adriancubasalvarez/radio-mundial/carcasa/README.md

# Radio Mundial — 3D printed cases

**English** · [Español](#español)

| Folder | What it is | Status |
|---|---|---|
| [`pequena/`](pequena/) | **Small case** for the Freenove FNK0104, using the speaker that comes with the board. It is the one shown in the video and in the build guide. | Ready to print |
| [`boombox/`](boombox/) | Reference parts to design a larger boombox version with two 4" speakers. | In progress |

The small case is also on [MakerWorld](https://makerworld.com/en/models/3568249) and [Printables](https://www.printables.com/model/1905906).

---

## Español

| Carpeta | Qué es | Estado |
|---|---|---|
| [`pequena/`](pequena/) | **Carcasa pequeña** para la Freenove FNK0104, con el altavoz que trae la placa. Es la que sale en el vídeo y en la guía de montaje. | Lista para imprimir |
| [`boombox/`](boombox/) | Piezas de referencia para diseñar una versión boombox más grande, con dos altavoces de 4". | En desarrollo |

La carcasa pequeña también está en [MakerWorld](https://makerworld.com/es/models/3568249) y [Printables](https://www.printables.com/model/1905906).

Licencia / License: CC BY-NC-SA 4.0 — see [`LICENSE-CONTENIDO.md`](../LICENSE-CONTENIDO.md).
