adriancubasalvarez/radio-mundial/carcasa/boombox/referencia/amplificador_bloque.step

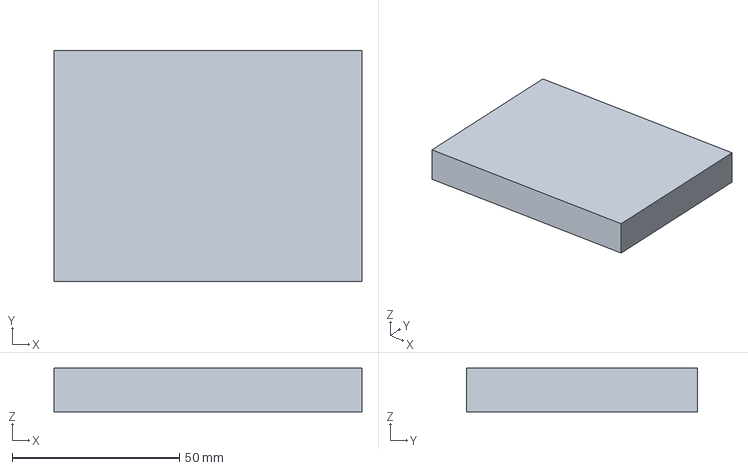
[picture p3: CAD file, 2026-11-08]
carcasa/boombox/referencia/amplificador_bloque.step
92.0 x 69.0 x 13.0 mm
