adriancubasalvarez/radio-mundial/carcasa/pequena/front.step

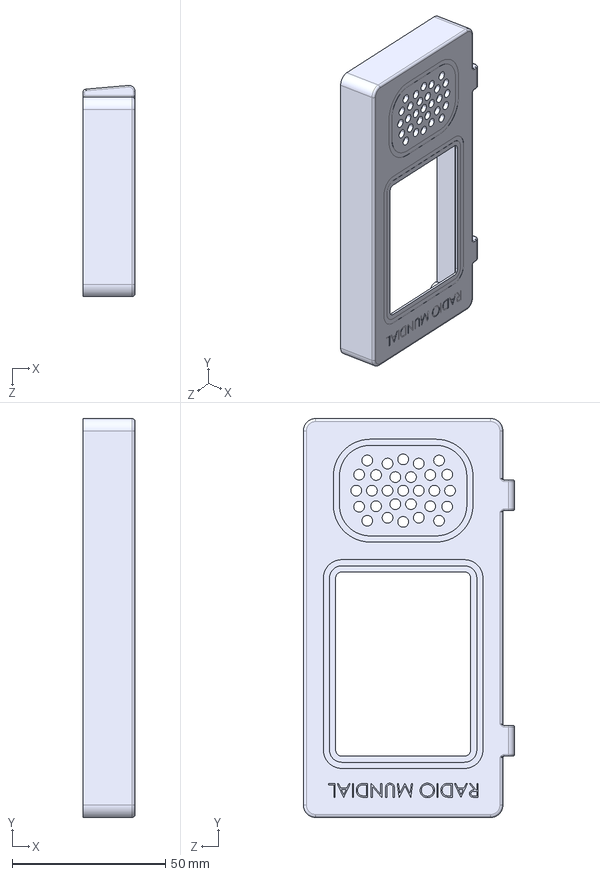
[picture p4: CAD file, 2026-11-07]
carcasa/pequena/front.step
17.0 x 130.0 x 68.8 mm
