adriancubasalvarez/radio-mundial/carcasa/boombox/referencia/altavoz_maniqui.step

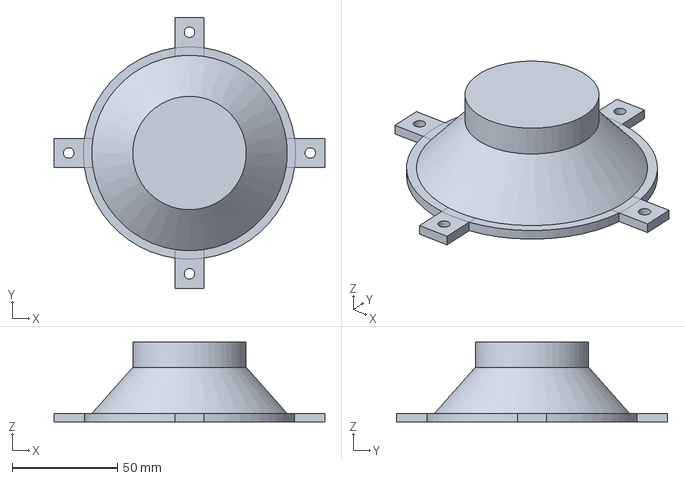
[picture p5: CAD file, 2026-11-08]
carcasa/boombox/referencia/altavoz_maniqui.step
129.0 x 129.0 x 38.0 mm
