adriancubasalvarez/radio-mundial/carcasa/pequena/back_cover.step

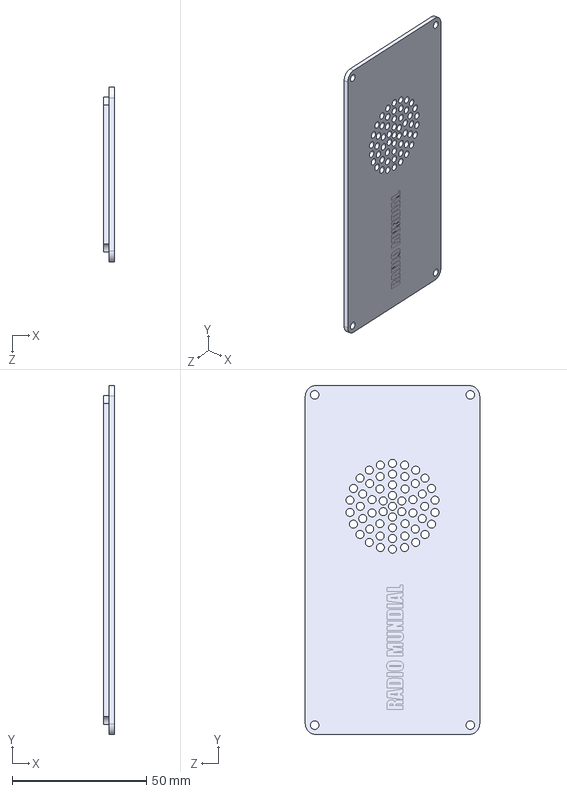
[picture p6: CAD file, 2026-11-07]
carcasa/pequena/back_cover.step
4.00 x 130.0 x 65.0 mm
