adriancubasalvarez/radio-mundial/carcasa/boombox/referencia/huevo_cavidad.step

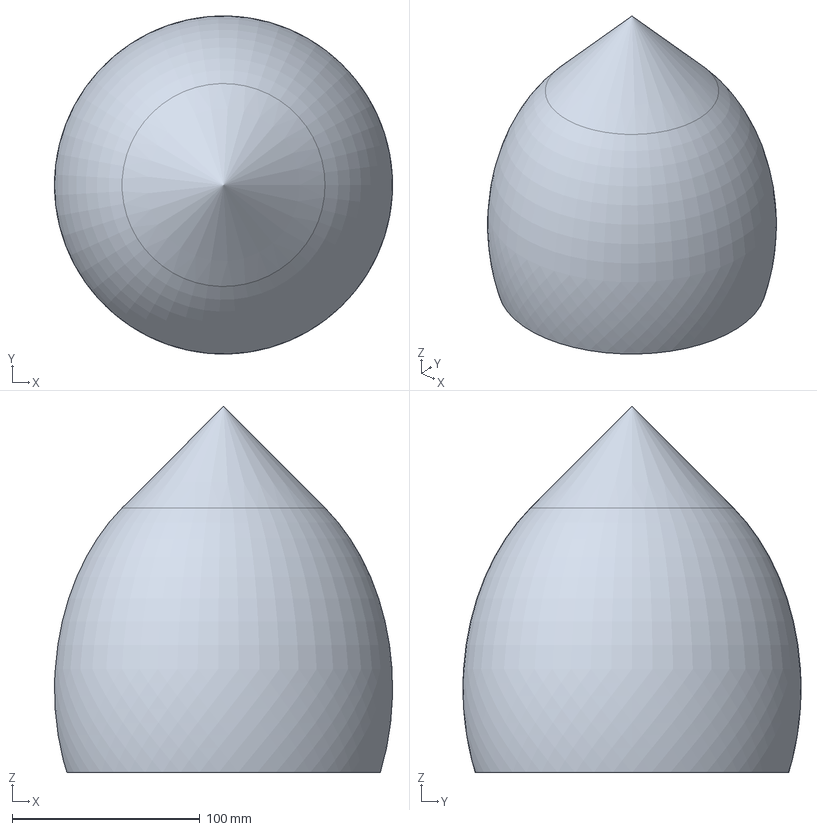
[picture p7: CAD file, 2026-11-08]
carcasa/boombox/referencia/huevo_cavidad.step
179.9 x 179.9 x 195.0 mm
