adriancubasalvarez/radio-mundial/(list of files, cad)

Other CAD files:
carcasa/boombox/referencia/altavoz_maniqui.stl
carcasa/boombox/referencia/amplificador_bloque.stl
carcasa/boombox/referencia/huevo_cavidad.stl
carcasa/pequena/back_cover.3mf
carcasa/pequena/back_cover.stl
carcasa/pequena/front.3mf
carcasa/pequena/front.stl
