adriancubasalvarez/radio-mundial/docs/manual/img/fotos/montaje.jpg

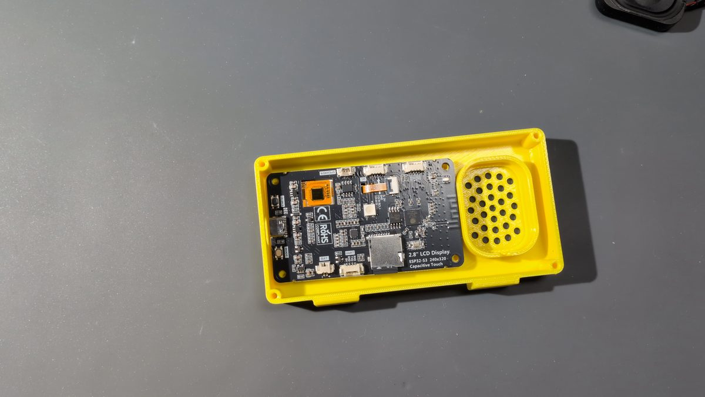
docs/manual/img/fotos/montaje.jpg
