adriancubasalvarez/radio-mundial/docs/manual/img/fotos/por_dentro.jpg

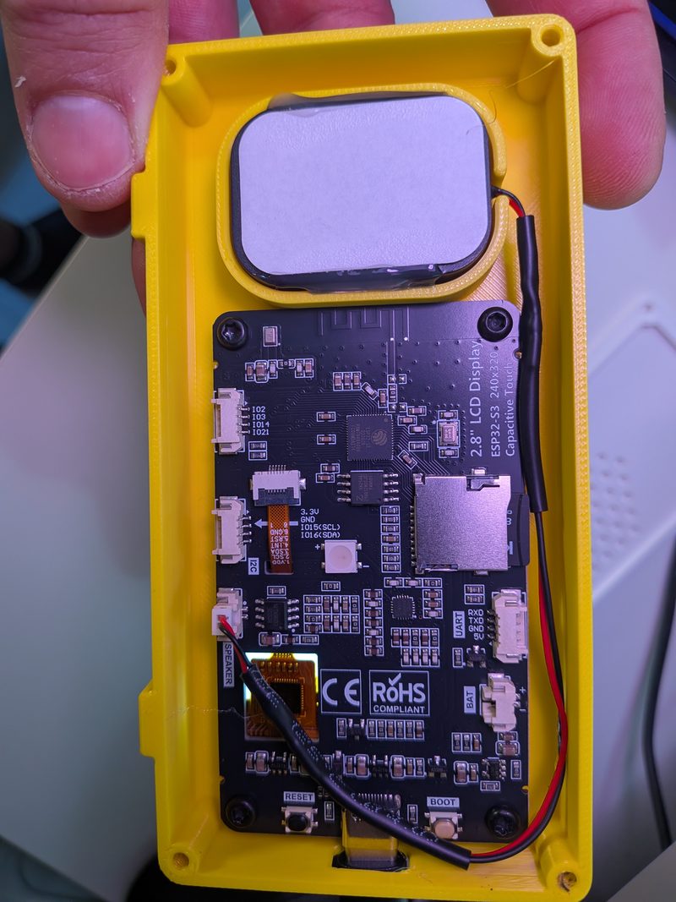
docs/manual/img/fotos/por_dentro.jpg
