adriancubasalvarez/radio-mundial/src/zonas.h

/* Generado por tools/build_zonas.py: no editar a mano.
 * Zona horaria de cada país (regla POSIX), ordenada por código. */
#pragma once

#include <stdint.h>

typedef struct {
    char codigo[3];
    const char *regla;
    uint32_t hasta;       /* si hay excepción, cuándo acaba (segundos Unix) */
    const char *despues;  /* y la regla que sigue */
} ZonaPais;

static const ZonaPais ZONAS[] = {
    {"AD", "CET-1CEST,M3.5.0,M10.5.0/3"},
    {"AE", "<+04>-4"},
    {"AF", "<+0430>-4:30"},
    {"AG", "AST4"},
    {"AI", "AST4"},
    {"AL", "CET-1CEST,M3.5.0,M10.5.0/3"},
    {"AM", "<+04>-4"},
    {"AO", "WAT-1"},
    {"AR", "<-03>3"},
    {"AS", "SST11"},
    {"AT", "CET-1CEST,M3.5.0,M10.5.0/3"},
    {"AU", "AEST-10AEDT,M10.1.0,M4.1.0/3"},
    {"AW", "AST4"},
    {"AX", "EET-2EEST,M3.5.0/3,M10.5.0/4"},
    {"AZ", "<+04>-4"},
    {"BA", "CET-1CEST,M3.5.0,M10.5.0/3"},
    {"BB", "AST4"},
    {"BD", "<+06>-6"},
    {"BE", "CET-1CEST,M3.5.0,M10.5.0/3"},
    {"BF", "GMT0"},
    {"BG", "EET-2EEST,M3.5.0/3,M10.5.0/4"},
    {"BH", "<+03>-3"},
    {"BI", "CAT-2"},
    {"BJ", "WAT-1"},
    {"BL", "AST4"},
    {"BM", "AST4ADT,M3.2.0,M11.1.0"},
    {"BN", "<+08>-8"},
    {"BO", "<-04>4"},
    {"BR", "<-03>3"},
    {"BS", "EST5EDT,M3.2.0,M11.1.0"},
    {"BT", "<+06>-6"},
    {"BW", "CAT-2"},
    {"BY", "<+03>-3"},
    {"BZ", "CST6"},
    {"CA", "EST5EDT,M3.2.0,M11.1.0"},
    {"CD", "WAT-1"},
    {"CF", "WAT-1"},
    {"CG", "WAT-1"},
    {"CH", "CET-1CEST,M3.5.0,M10.5.0/3"},
    {"CI", "GMT0"},
    {"CK", "<-10>10"},
    {"CL", "<-04>4<-03>,M9.1.6/24,M4.1.6/24"},
    {"CM", "WAT-1"},
    {"CN", "CST-8"},
    {"CO", "<-05>5"},
    {"CR", "CST6"},
    {"CU", "CDT4", 1825563600, "CST5CDT,M3.2.0/0,M11.1.0/1"},
    {"CV", "<-01>1"},
    {"CW", "AST4"},
    {"CY", "EET-2EEST,M3.5.0/3,M10.5.0/4"},
    {"CZ", "CET-1CEST,M3.5.0,M10.5.0/3"},
    {"DE", "CET-1CEST,M3.5.0,M10.5.0/3"},
    {"DJ", "EAT-3"},
    {"DK", "CET-1CEST,M3.5.0,M10.5.0/3"},
    {"DM", "AST4"},
    {"DO", "AST4"},
    {"DZ", "CET-1"},
    {"EC", "<-05>5"},
    {"EE", "EET-2EEST,M3.5.0/3,M10.5.0/4"},
    {"EG", "EET-2EEST,M4.5.5/0,M10.5.4/24"},
    {"EH", "<+00>0"},
    {"ER", "EAT-3"},
    {"ES", "CET-1CEST,M3.5.0,M10.5.0/3"},
    {"ET", "EAT-3"},
    {"FI", "EET-2EEST,M3.5.0/3,M10.5.0/4"},
    {"FJ", "<+12>-12"},
    {"FK", "<-03>3"},
    {"FM", "<+10>-10"},
    {"FO", "WET0WEST,M3.5.0/1,M10.5.0"},
    {"FR", "CET-1CEST,M3.5.0,M10.5.0/3"},
    {"GA", "WAT-1"},
    {"GB", "GMT0BST,M3.5.0/1,M10.5.0"},
    {"GD", "AST4"},
    {"GE", "<+04>-4"},
    {"GG", "GMT0BST,M3.5.0/1,M10.5.0"},
    {"GH", "GMT0"},
    {"GL", "<-02>2<-01>,M3.5.0/-1,M10.5.0/0"},
    {"GM", "GMT0"},
    {"GN", "GMT0"},
    {"GQ", "WAT-1"},
    {"GR", "EET-2EEST,M3.5.0/3,M10.5.0/4"},
    {"GT", "CST6"},
    {"GU", "ChST-10"},
    {"GW", "GMT0"},
    {"GY", "<-04>4"},
    {"HK", "HKT-8"},
    {"HN", "CST6"},
    {"HR", "CET-1CEST,M3.5.0,M10.5.0/3"},
    {"HT", "EST5EDT,M3.2.0,M11.1.0"},
    {"HU", "CET-1CEST,M3.5.0,M10.5.0/3"},
    {"ID", "WIB-7"},
    {"IE", "IST-1GMT0,M10.5.0,M3.5.0/1"},
    {"IL", "IST-2IDT,M3.4.4/26,M10.5.0"},
    {"IM", "GMT0BST,M3.5.0/1,M10.5.0"},
    {"IN", "IST-5:30"},
    {"IQ", "<+03>-3"},
    {"IR", "<+0330>-3:30"},
    {"IS", "GMT0"},
    {"IT", "CET-1CEST,M3.5.0,M10.5.0/3"},
    {"JE", "GMT0BST,M3.5.0/1,M10.5.0"},
    {"JM", "EST5"},
    {"JO", "<+03>-3"},
    {"JP", "JST-9"},
    {"KE", "EAT-3"},
    {"KG", "<+06>-6"},
    {"KH", "<+07>-7"},
    {"KI", "<+12>-12"},
    {"KM", "EAT-3"},
    {"KN", "AST4"},
    {"KP", "KST-9"},
    {"KR", "KST-9"},
    {"KW", "<+03>-3"},
    {"KY", "EST5"},
    {"KZ", "<+05>-5"},
    {"LA", "<+07>-7"},
    {"LB", "EET-2EEST,M3.5.0/0,M10.5.0/0"},
    {"LC", "AST4"},
    {"LI", "CET-1CEST,M3.5.0,M10.5.0/3"},
    {"LK", "<+0530>-5:30"},
    {"LR", "GMT0"},
    {"LS", "SAST-2"},
    {"LT", "EET-2EEST,M3.5.0/3,M10.5.0/4"},
    {"LU", "CET-1CEST,M3.5.0,M10.5.0/3"},
    {"LV", "EET-2EEST,M3.5.0/3,M10.5.0/4"},
    {"LY", "EET-2"},
    {"MA", "<+00>0"},
    {"MC", "CET-1CEST,M3.5.0,M10.5.0/3"},
    {"MD", "EET-2EEST,M3.5.0/3,M10.5.0/4"},
    {"ME", "CET-1CEST,M3.5.0,M10.5.0/3"},
    {"MF", "AST4"},
    {"MG", "EAT-3"},
    {"MH", "<+12>-12"},
    {"MK", "CET-1CEST,M3.5.0,M10.5.0/3"},
    {"ML", "GMT0"},
    {"MM", "<+0630>-6:30"},
    {"MN", "<+08>-8"},
    {"MO", "CST-8"},
    {"MP", "ChST-10"},
    {"MR", "GMT0"},
    {"MS", "AST4"},
    {"MT", "CET-1CEST,M3.5.0,M10.5.0/3"},
    {"MU", "<+04>-4"},
    {"MV", "<+05>-5"},
    {"MW", "CAT-2"},
    {"MX", "CST6"},
    {"MY", "<+08>-8"},
    {"MZ", "CAT-2"},
    {"NA", "CAT-2"},
    {"NC", "<+11>-11"},
    {"NE", "WAT-1"},
    {"NF", "<+11>-11<+12>,M10.1.0,M4.1.0/3"},
    {"NG", "WAT-1"},
    {"NI", "CST6"},
    {"NL", "CET-1CEST,M3.5.0,M10.5.0/3"},
    {"NO", "CET-1CEST,M3.5.0,M10.5.0/3"},
    {"NP", "<+0545>-5:45"},
    {"NR", "<+12>-12"},
    {"NU", "<-11>11"},
    {"NZ", "NZST-12NZDT,M9.5.0,M4.1.0/3"},
    {"OM", "<+04>-4"},
    {"PA", "EST5"},
    {"PE", "<-05>5"},
    {"PF", "<-10>10"},
    {"PG", "<+10>-10"},
    {"PH", "PST-8"},
    {"PK", "PKT-5"},
    {"PL", "CET-1CEST,M3.5.0,M10.5.0/3"},
    {"PM", "<-03>3<-02>,M3.2.0,M11.1.0"},
    {"PN", "<-08>8"},
    {"PR", "AST4"},
    {"PS", "EET-2EEST,M3.4.4/50,M10.4.4/50"},
    {"PT", "WET0WEST,M3.5.0/1,M10.5.0"},
    {"PW", "<+09>-9"},
    {"PY", "<-03>3"},
    {"QA", "<+03>-3"},
    {"RO", "EET-2EEST,M3.5.0/3,M10.5.0/4"},
    {"RS", "CET-1CEST,M3.5.0,M10.5.0/3"},
    {"RU", "MSK-3"},
    {"RW", "CAT-2"},
    {"SA", "<+03>-3"},
    {"SB", "<+11>-11"},
    {"SC", "<+04>-4"},
    {"SD", "CAT-2"},
    {"SE", "CET-1CEST,M3.5.0,M10.5.0/3"},
    {"SG", "<+08>-8"},
    {"SH", "GMT0"},
    {"SI", "CET-1CEST,M3.5.0,M10.5.0/3"},
    {"SK", "CET-1CEST,M3.5.0,M10.5.0/3"},
    {"SL", "GMT0"},
    {"SM", "CET-1CEST,M3.5.0,M10.5.0/3"},
    {"SN", "GMT0"},
    {"SO", "EAT-3"},
    {"SR", "<-03>3"},
    {"SS", "CAT-2"},
    {"ST", "GMT0"},
    {"SV", "CST6"},
    {"SX", "AST4"},
    {"SY", "<+03>-3"},
    {"SZ", "SAST-2"},
    {"TC", "EST5EDT,M3.2.0,M11.1.0"},
    {"TD", "WAT-1"},
    {"TG", "GMT0"},
    {"TH", "<+07>-7"},
    {"TJ", "<+05>-5"},
    {"TL", "<+09>-9"},
    {"TM", "<+05>-5"},
    {"TN", "CET-1"},
    {"TO", "<+13>-13"},
    {"TR", "<+03>-3"},
    {"TT", "AST4"},
    {"TV", "<+12>-12"},
    {"TW", "CST-8"},
    {"TZ", "EAT-3"},
    {"UA", "MSK-3"},
    {"UG", "EAT-3"},
    {"US", "EST5EDT,M3.2.0,M11.1.0"},
    {"UY", "<-03>3"},
    {"UZ", "<+05>-5"},
    {"VA", "CET-1CEST,M3.5.0,M10.5.0/3"},
    {"VC", "AST4"},
    {"VE", "<-04>4"},
    {"VG", "AST4"},
    {"VI", "AST4"},
    {"VN", "<+07>-7"},
    {"VU", "<+11>-11"},
    {"WF", "<+12>-12"},
    {"WS", "<+13>-13"},
    {"XK", "CET-1CEST,M3.5.0,M10.5.0/3"},
    {"YE", "<+03>-3"},
    {"ZA", "SAST-2"},
    {"ZM", "CAT-2"},
    {"ZW", "CAT-2"},
};
