adriancubasalvarez/radio-mundial/include/marca.h

/**
 * Nombre, versión y autor.
 * El logo está en data/logo.bin (se genera con tools/build_logo.py a partir
 * de assets/logo.png).
 */
#pragma once

#define MARCA_NOMBRE  "Radio Mundial"
#define MARCA_AUTOR   "@Adriancubas1980"
#define MARCA_VERSION "v0.4.1"

/* De aquí descarga la radio las emisoras nuevas (publicado desde docs/emisoras) */
#define MARCA_URL_EMISORAS "https://adriancubasalvarez.github.io/radio-mundial/emisoras/"
