adriancubasalvarez/radio-mundial/src/ui/ui_ajustes.cpp

/**
 * Menú de ajustes rápido: se abre manteniendo pulsado el título del
 * mapamundi. Permite cambiar el idioma, la red WiFi y la luz, y apagar la
 * radio.
 * Se dibuja en la capa superior de LVGL, encima del mapamundi.
 */
#include "ui.h"
#include "nav.h"
#include "comun.h"
#include "ajustes.h"
#include "alarmas.h"
#include "hal.h"
#include "idioma.h"
#include "luz.h"

#include <lvgl.h>

static lv_obj_t *capa;

static void cerrar(void)
{
    if (capa != NULL) {
        lv_obj_del_async(capa);
        capa = NULL;
    }
}

static void al_cerrar(lv_event_t *e)
{
    (void)e;
    cerrar();
}

static void al_elegir_idioma(lv_event_t *e)
{
    bool espanol = (bool)(uintptr_t)lv_event_get_user_data(e);
    cerrar();
    if (espanol != ajustes.espanol) {
        ajustes_poner_idioma(espanol);
        datos_cargar_indice(&nav.indice);  /* nombres de regiones en el nuevo idioma */
        nav_reiniciar();                   /* rehace el mapamundi con los textos nuevos */
    }
}

static void al_alarmas(lv_event_t *e)
{
    (void)e;
    cerrar();
    nav_ir(PANT_ALARMAS);
}

static void al_actualizar(lv_event_t *e)
{
    (void)e;
    cerrar();
    nav_ir(PANT_ACTUALIZAR);
}

static void al_wifi(lv_event_t *e)
{
    (void)e;
    cerrar();
    hal_red_configurar();
}

/* Texto del botón de la luz según el modo elegido */
static const char *texto_luz(void)
{
    switch (ajustes.luz) {
    case LUZ_APAGADA: return TR("Light: off", "Luz: no");
    case LUZ_ESTADO: return TR("Light: on", "Luz: fija");
    default: return TR("Light: beat", "Luz: ritmo");
    }
}

/* Cada toque pasa al siguiente modo: ritmo -> apagada -> fija -> ritmo */
static void al_luz(lv_event_t *e)
{
    ajustes.luz = (uint8_t)((ajustes.luz + 1) % NUM_MODOS_LUZ);
    ajustes_guardar();
    lv_label_set_text(lv_obj_get_child(lv_event_get_target(e), 0), texto_luz());
}

static const char *texto_brillo(void)
{
    switch (ajustes.luz_brillo) {
    case 0: return TR("Glow: low", "Brillo: bajo");
    case 1: return TR("Glow: medium", "Brillo: medio");
    default: return TR("Glow: high", "Brillo: alto");
    }
}

/* Cada toque pasa a la siguiente intensidad: baja -> media -> alta */
static void al_brillo(lv_event_t *e)
{
    ajustes.luz_brillo = (uint8_t)((ajustes.luz_brillo + 1) % NUM_BRILLOS_LUZ);
    ajustes_guardar();
    lv_label_set_text(lv_obj_get_child(lv_event_get_target(e), 0), texto_brillo());
}

/* Salida de audio: altavoz integrado o DAC externo (I2S) hacia un
 * amplificador. Si suena una emisora, sigue sonando por la nueva salida. */
static const char *texto_salida(void)
{
    return ajustes.salida_externa ? LV_SYMBOL_AUDIO " DAC" : LV_SYMBOL_VOLUME_MAX;
}

static void al_salida(lv_event_t *e)
{
    ajustes.salida_externa = !ajustes.salida_externa;
    ajustes_guardar();
    audio_salida(ajustes.salida_externa);
    /* resaltado (como un botón marcado) mientras se usa el DAC externo */
    lv_obj_t *b = lv_event_get_target(e);
    lv_obj_t *etiqueta = lv_obj_get_child(b, 0);
    lv_obj_set_style_bg_color(b, lv_color_hex(ajustes.salida_externa ? COLOR_ACENTO : COLOR_LINEA), 0);
    lv_obj_set_style_text_color(etiqueta, lv_color_hex(ajustes.salida_externa ? COLOR_FONDO : COLOR_TEXTO), 0);
    lv_label_set_text(etiqueta, texto_salida());
}

/* El deslizador vale si el dedo empieza en su mitad izquierda y llega cerca
 * del final: así cuesta poco apagar, pero un toque suelto no apaga */
static bool empezo_a_la_izquierda;

static void al_pulsar_deslizador(lv_event_t *e)
{
    lv_obj_t *deslizador = lv_event_get_target(e);
    lv_point_t punto;
    lv_indev_get_point(lv_indev_get_act(), &punto);
    empezo_a_la_izquierda = punto.x < deslizador->coords.x1 + lv_obj_get_width(deslizador) / 2;
}

/* Al soltar: si llegó casi al final se apaga; si no, vuelve atrás */
static void al_deslizar(lv_event_t *e)
{
    lv_obj_t *deslizador = lv_event_get_target(e);
    if (!empezo_a_la_izquierda || lv_slider_get_value(deslizador) < 80) {
        lv_slider_set_value(deslizador, 0, LV_ANIM_ON);
        return;
    }
    audio_parar();
    ajustes_guardar();
    hal_apagar(alarmas_segundos_para_despertar());
}

/* «Desliza para apagar»: hay que arrastrar el botón redondo hacia el final,
 * así no se apaga con un toque sin querer */
static void deslizador_apagar(lv_obj_t *padre)
{
    lv_obj_t *d = lv_slider_create(padre);
    lv_obj_set_size(d, 260 - 40, 40);  /* el botón sobresale media altura a cada lado */
    lv_slider_set_range(d, 0, 100);
    lv_obj_set_ext_click_area(d, 8);
    lv_obj_set_style_radius(d, 20, LV_PART_MAIN);
    lv_obj_set_style_bg_color(d, lv_color_hex(COLOR_LINEA), LV_PART_MAIN);
    lv_obj_set_style_radius(d, 20, LV_PART_INDICATOR);
    lv_obj_set_style_bg_color(d, lv_color_hex(COLOR_ERROR), LV_PART_INDICATOR);
    lv_obj_set_style_bg_color(d, lv_color_hex(COLOR_ERROR), LV_PART_KNOB);
    lv_obj_set_style_pad_all(d, 0, LV_PART_KNOB);
    lv_obj_add_event_cb(d, al_pulsar_deslizador, LV_EVENT_PRESSED, NULL);
    lv_obj_add_event_cb(d, al_deslizar, LV_EVENT_RELEASED, NULL);

    lv_obj_t *etiqueta = lv_label_create(d);
    lv_label_set_text(etiqueta, TR(LV_SYMBOL_POWER "  Slide to power off", LV_SYMBOL_POWER "  Desliza para apagar"));
    lv_obj_set_style_text_font(etiqueta, &radio_14, 0);
    lv_obj_set_style_text_color(etiqueta, lv_color_hex(COLOR_SECUNDARIO), 0);
    lv_obj_center(etiqueta);
}

static lv_obj_t *boton(lv_obj_t *padre, const char *texto, bool marcado, lv_event_cb_t accion, void *dato,
                       lv_coord_t ancho = 260)
{
    lv_obj_t *b = lv_btn_create(padre);
    lv_obj_set_size(b, ancho, 40);
    lv_obj_set_style_radius(b, 10, 0);
    lv_obj_set_style_bg_color(b, lv_color_hex(marcado ? COLOR_ACENTO : COLOR_LINEA), 0);
    lv_obj_add_event_cb(b, accion, LV_EVENT_CLICKED, dato);
    lv_obj_t *etiqueta = lv_label_create(b);
    lv_label_set_text(etiqueta, texto);
    lv_obj_set_style_text_font(etiqueta, &radio_20, 0);
    lv_obj_set_style_text_color(etiqueta, lv_color_hex(marcado ? COLOR_FONDO : COLOR_TEXTO), 0);
    lv_obj_center(etiqueta);
    return b;
}

void ui_ajustes_abrir(void)
{
    if (capa != NULL) {
        return;
    }
    capa = lv_obj_create(lv_layer_top());
    lv_obj_remove_style_all(capa);
    lv_obj_set_size(capa, PANTALLA_ANCHO, PANTALLA_ALTO);
    lv_obj_set_style_bg_color(capa, lv_color_hex(COLOR_FONDO), 0);
    lv_obj_set_style_bg_opa(capa, LV_OPA_COVER, 0);
    lv_obj_add_flag(capa, LV_OBJ_FLAG_CLICKABLE);  /* que no pasen toques debajo */
    lv_obj_set_flex_flow(capa, LV_FLEX_FLOW_COLUMN);
    lv_obj_set_flex_align(capa, LV_FLEX_ALIGN_START, LV_FLEX_ALIGN_CENTER, LV_FLEX_ALIGN_CENTER);
    lv_obj_set_style_pad_top(capa, 10, 0);
    lv_obj_set_style_pad_row(capa, 8, 0);

    lv_obj_t *titulo = lv_label_create(capa);
    lv_label_set_text(titulo, TR(LV_SYMBOL_SETTINGS "  Settings", LV_SYMBOL_SETTINGS "  Ajustes"));
    lv_obj_set_style_text_font(titulo, &radio_20, 0);
    lv_obj_set_style_text_color(titulo, lv_color_hex(COLOR_ACENTO), 0);

    /* Actualizar emisoras: en la esquina, que el menú ya va lleno */
    lv_obj_t *actualizar = boton(capa, LV_SYMBOL_DOWNLOAD, false, al_actualizar, NULL, 46);
    lv_obj_add_flag(actualizar, LV_OBJ_FLAG_IGNORE_LAYOUT);
    lv_obj_set_height(actualizar, 32);
    lv_obj_align(actualizar, LV_ALIGN_TOP_RIGHT, -30, 6);

    /* Salida de audio, en la otra esquina: altavoz (integrado) o DAC (externo) */
    lv_obj_t *salida = boton(capa, texto_salida(), ajustes.salida_externa, al_salida, NULL, 64);
    lv_obj_add_flag(salida, LV_OBJ_FLAG_IGNORE_LAYOUT);
    lv_obj_set_height(salida, 32);
    lv_obj_set_style_text_font(lv_obj_get_child(salida, 0), &radio_14, 0);
    lv_obj_align(salida, LV_ALIGN_TOP_LEFT, 30, 6);

    /* Idioma (el botón ofrece el otro) y alarmas, en una fila */
    lv_obj_t *fila = lv_obj_create(capa);
    lv_obj_remove_style_all(fila);
    lv_obj_set_size(fila, 260, LV_SIZE_CONTENT);
    lv_obj_set_flex_flow(fila, LV_FLEX_FLOW_ROW);
    lv_obj_set_flex_align(fila, LV_FLEX_ALIGN_SPACE_BETWEEN, LV_FLEX_ALIGN_CENTER, LV_FLEX_ALIGN_CENTER);
    boton(fila, ajustes.espanol ? "English" : "Español", false, al_elegir_idioma, (void *)(uintptr_t)!ajustes.espanol, 126);
    boton(fila, TR(LV_SYMBOL_BELL " Alarms", LV_SYMBOL_BELL " Alarmas"), false, al_alarmas, NULL, 126);

    /* Red WiFi y luz, en otra fila */
    fila = lv_obj_create(capa);
    lv_obj_remove_style_all(fila);
    lv_obj_set_size(fila, 260, LV_SIZE_CONTENT);
    lv_obj_set_flex_flow(fila, LV_FLEX_FLOW_ROW);
    lv_obj_set_flex_align(fila, LV_FLEX_ALIGN_SPACE_BETWEEN, LV_FLEX_ALIGN_CENTER, LV_FLEX_ALIGN_CENTER);
    boton(fila, TR(LV_SYMBOL_WIFI " Wi-Fi", LV_SYMBOL_WIFI " Red WiFi"), false, al_wifi, NULL, 126);
    boton(fila, texto_luz(), false, al_luz, NULL, 126);
    deslizador_apagar(capa);

    /* Intensidad de la luz y Cerrar, en la última fila */
    fila = lv_obj_create(capa);
    lv_obj_remove_style_all(fila);
    lv_obj_set_size(fila, 260, LV_SIZE_CONTENT);
    lv_obj_set_flex_flow(fila, LV_FLEX_FLOW_ROW);
    lv_obj_set_flex_align(fila, LV_FLEX_ALIGN_SPACE_BETWEEN, LV_FLEX_ALIGN_CENTER, LV_FLEX_ALIGN_CENTER);
    lv_obj_t *brillo = boton(fila, texto_brillo(), false, al_brillo, NULL, 126);
    lv_obj_set_style_text_font(lv_obj_get_child(brillo, 0), &radio_14, 0);  /* texto largo */
    boton(fila, TR("Close", "Cerrar"), false, al_cerrar, NULL, 126);
}
