adriancubasalvarez/radio-mundial/src/ui/ui.h

/**
 * Interfaz de usuario (pantallas LVGL). Mismo código en el PC y en la placa.
 */
#pragma once

/* Crea la primera pantalla */
void ui_inicio(void);

/* Muestra la pantalla de arranque (logo); al acabar abre el mapamundi */
void ui_arranque(void);

/* Activa la pantalla de reposo (reloj) tras un rato sin tocar la pantalla */
void reposo_iniciar(void);

/* Quita la pantalla de reposo si está puesta */
void reposo_despertar(void);

/* Aviso a pantalla completa de una alarma sonando */
void alarma_mostrar(int hora, int minuto);

/* Quita ese aviso */
void alarma_cerrar(void);

/* Muestra la pantalla del portal WiFi cuando está abierto */
void red_ui_iniciar(void);

/* Abre el menú de ajustes (idioma y WiFi) */
void ui_ajustes_abrir(void);
