adriancubasalvarez/radio-mundial/src/ui/nav.h

/**
 * Navegación entre pantallas.
 *
 * Cada pantalla se construye al entrar y se destruye al salir (así solo hay
 * en memoria un mapa a la vez, importante en la placa). Una pila recuerda el
 * camino para que «Atrás» funcione siempre igual:
 *
 *   mundo -> región -> (lista de países) -> emisoras -> reproduciendo
 */
#pragma once

#include "datos.h"

#include <lvgl.h>

typedef enum {
    PANT_MUNDO,
    PANT_REGION,
    PANT_PAISES,
    PANT_EMISORAS,
    PANT_SONANDO,
    PANT_FAVORITOS,
    PANT_BUSCAR,
    PANT_GENERO,
    PANT_MIS_EMISORAS,
    PANT_ALARMAS,
    PANT_ALARMA,
    PANT_ALARMA_SONIDO,
    PANT_RECIENTES,
    PANT_ACTUALIZAR,
} Pantalla;

/* Lo elegido hasta ahora en el recorrido */
typedef struct {
    IndiceMundo indice;   /* regiones.json */
    Region region;        /* región elegida */
    Pais pais;            /* país elegido */
    Emisora emisora;      /* emisora elegida en la lista */
    Emisora sonando;      /* emisora que está sonando (puede ser otra) */
    bool hay_sonando;     /* true si deberíamos estar oyendo "sonando" */
    bool aleatoria;       /* «Reproduciendo» en modo emisora aleatoria */
    int genero;           /* posición en GENEROS del género elegido */
} EstadoNav;

extern EstadoNav nav;

/* Abre una pantalla nueva encima de la actual */
void nav_ir(Pantalla pantalla);

/* Vuelve a la pantalla anterior */
void nav_atras(void);

/* Va a la lista de emisoras de nav.pais, con el camino de vuelta por su
 * región y el mapamundi, se llegara como se llegara hasta aquí */
void nav_ir_al_pais(void);

/* Olvida el recorrido y vuelve a crear el mapamundi (p. ej. al cambiar de idioma) */
void nav_reiniciar(void);

/* Constructores de cada pantalla (devuelven un objeto pantalla de LVGL) */
lv_obj_t *pantalla_mundo(void);
lv_obj_t *pantalla_region(void);
lv_obj_t *pantalla_paises(void);
lv_obj_t *pantalla_emisoras(void);
lv_obj_t *pantalla_sonando(void);
/* Vigila lo que suena; llamarlo en cada vuelta del bucle principal */
void nav_atender(void);

lv_obj_t *pantalla_favoritos(void);
lv_obj_t *pantalla_recientes(void);
lv_obj_t *pantalla_actualizar(void);
lv_obj_t *pantalla_buscar(void);
lv_obj_t *pantalla_genero(void);
lv_obj_t *pantalla_mis_emisoras(void);
lv_obj_t *pantalla_alarmas(void);
lv_obj_t *pantalla_alarma(void);
lv_obj_t *pantalla_alarma_sonido(void);

/* Olvida la última búsqueda (al entrar en «Buscar» desde el mapamundi) */
void buscar_desde_cero(void);

/* Pone a sonar nav.emisora (de nav.pais) y la recuerda como última */
void nav_reproducir(void);
