adriancubasalvarez/radio-mundial/src/ui/ui_emisoras.cpp

/**
 * Lista desplazable de las emisoras de un país.
 * Las emisoras se cargan al entrar y se liberan al salir.
 */
#include "nav.h"
#include "comun.h"
#include "ajustes.h"
#include "hal.h"
#include "idioma.h"

#include <lvgl.h>
#include <string.h>

static ListaEmisoras emisoras;

static void al_elegir(uint16_t fila)
{
    nav.emisora = emisoras.emisoras[fila];
    nav.aleatoria = false;
    nav_ir(PANT_SONANDO);
}

/* Lleva al final las emisoras que vienen fallando, sin cambiar el orden del
 * resto. Devuelve cuántas quedan arriba. */
static uint16_t bajar_flojas(void)
{
    uint16_t buenas = emisoras.num;
    for (uint16_t i = 0; i < buenas;) {
        if (ajustes_emisora_floja(emisoras.emisoras[i].url)) {
            Emisora floja = emisoras.emisoras[i];
            memmove(&emisoras.emisoras[i], &emisoras.emisoras[i + 1], (emisoras.num - i - 1) * sizeof(Emisora));
            emisoras.emisoras[emisoras.num - 1] = floja;
            buenas--;
        } else {
            i++;
        }
    }
    return buenas;
}

static void al_borrar(lv_event_t *e)
{
    (void)e;
    datos_liberar_emisoras(&emisoras);
}

lv_obj_t *pantalla_emisoras(void)
{
    lv_obj_t *pantalla = comun_pantalla();
    lv_obj_add_event_cb(pantalla, al_borrar, LV_EVENT_DELETE, NULL);
    comun_cabecera(pantalla, nav.pais.nombre, true, NULL);

    if (!datos_cargar_emisoras(nav.pais.codigo, &emisoras) || emisoras.num == 0) {
        lv_obj_t *aviso = lv_label_create(pantalla);
        lv_label_set_text(aviso, TR("No stations for\nthis country yet", "Todavía no hay emisoras\nde este país"));
        lv_obj_set_style_text_font(aviso, &radio_20, 0);
        lv_obj_set_style_text_color(aviso, lv_color_hex(COLOR_SECUNDARIO), 0);
        lv_obj_set_style_text_align(aviso, LV_TEXT_ALIGN_CENTER, 0);
        lv_obj_align(aviso, LV_ALIGN_CENTER, 0, ALTO_CABECERA / 2);
        return pantalla;
    }

    uint16_t buenas = bajar_flojas();
    lv_obj_t *lista = comun_lista(pantalla, al_elegir);
    for (uint16_t i = 0; i < emisoras.num; i++) {
        const Emisora *em = &emisoras.emisoras[i];
        /* Icono: altavoz si está sonando, estrella si es favorita, nota si no */
        bool suena = nav.hay_sonando && strcmp(nav.sonando.url, em->url) == 0;
        const char *icono = suena ? LV_SYMBOL_VOLUME_MAX
                          : ajustes_es_favorito(em->url) ? SIMBOLO_ESTRELLA : LV_SYMBOL_AUDIO;
        comun_lista_agregar(lista, icono, em->nombre, NULL, false);
        if (i >= buenas) {
            comun_lista_gris(lista);
        }
    }
    return pantalla;
}
