adriancubasalvarez/radio-mundial/(commit log)

2026-10-30 Versión de PC de Radio Mundial: simulador, mapas, emisoras y logo
    - Simulador LVGL 8.4 + SDL2 en PlatformIO (entorno pc), con capa HAL
    para pantalla, táctil, archivos y audio (ffplay en el PC).
    - Navegación completa: mapamundi -> región -> país -> emisoras ->
    reproduciendo, con aviso si una emisora falla.
    - tools/build_maps.py: mapas de Natural Earth en formato LVGL indexado
    de 8 bits y zonas táctiles.
    - tools/build_stations.py: 3.647 emisoras de radio-browser.info en 209
    países, comprobadas con ffprobe.
    - tools/build_fonts.py: Montserrat con tildes y ñ (Latin-1).
    - tools/build_logo.py y pantalla de arranque con la firma del creador.
    - Modo guion (RADIO_GUION) para probar el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
2026-10-30 Pulido en el PC: favoritos, aleatoria, título ICY y reposo
    - Ajustes persistentes (volumen, última emisora, favoritos, reposo) en
    ajustes.json a través de la HAL; al arrancar vuelve a sonar la última.
    - Favoritos: estrella en «Reproduciendo» y lista desde el mapamundi
    (máximo 20).
    - Emisora aleatoria del mundo, con botón «otra» y salto automático si
    una emisora no responde.
    - Título de la canción (metadatos ICY): en el PC lo lee un hilo con una
    segunda conexión (solo http://); se muestra en «Reproduciendo» y en el
    pie del mapamundi.
    - Pantalla de reposo con reloj grande y brillo bajo tras 2 minutos.
    - Listas con el fondo de la aplicación y separadores; fuentes con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
2026-10-31 Buscador, géneros y tarjeta SD opcional
    - Buscador con teclado en pantalla: busca por palabras en el nombre
    mientras se escribe, de la emisora más popular del mundo a la menos.
    - 13 géneros sacados de las etiquetas de radio-browser (pop, rock,
    noticias, jazz, clásica, latina...): «Buscar» sin texto los lista.
    - build_stations.py genera data/buscar.txt (índice de 155 KB) y admite
    --destino sd para crear una base más grande en sd/radio/.
    - HAL: lectura de archivos línea a línea y tarjeta SD opcional; los
    datos de la SD (radio/) tienen prioridad sobre los internos.
    - SD: mis_emisoras.csv con emisoras propias y copia automática de
    ajustes y favoritos, que se recuperan si la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
    [mis_emisoras.csv]
2026-10-31 Primera versión en placa (CYD FNK0114F), licencias y README
    - Entorno cyd: Freenove FNK0114F (ESP32 sin PSRAM, 4 MB), particiones
    con 2 MB de LittleFS; pines del repositorio oficial de Freenove,
    probados en el contador de YouTube.
    - HAL de la placa: pantalla con LovyanGFX, táctil XPT2046 por SPI
    software, LittleFS + SD opcional, ajustes en NVS, hora por NTP.
    - Mapas leídos de la flash línea a línea con un decodificador propio de
    LVGL: en RAM solo quedan paleta y zonas (antes 67 KB por mapa).
    - Memoria de LVGL reservada con malloc en la placa (96 KB).
    - Audio con ESP32-audioI2S 2.0.6 por el DAC interno (aún sin probar).
    - Licencias: GPL-3.0 para el código (lo exige ESP32-audioI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
    [particiones_4mb.csv]
2026-10-31 Portal WiFi, Improv, listas ligeras y ajustes de memoria en la CYD
    - Red: portal cautivo con WiFiManager (red «RadioMundial-XXXX», pantalla
    con QR) si no hay WiFi guardada o no conecta en 45 s; Improv por el
    puerto serie para que ESP Web Tools mande la WiFi al instalar; pulsación
    larga en la cabecera para cambiar de red. Quitado wifi.txt.
    - Listas con lv_table: un solo objeto por lista (África: 75 KB -> 22 KB
    de memoria de LVGL).
    - CYD: LVGL se inicia antes que WiFi y audio; memoria de LVGL y búfer de
    dibujo configurables por placa (32 KB y 10 líneas); el audio se crea al
    pedir la primera emisora y avisa si no hay memoria en vez de colgarse.
    - Pendiente: en la CYD aún falt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
2026-10-31 CYD: WiFi sin PMF, audio que espera a la WiFi y SD desactivada
    - WiFi: la conexión a la red guardada se intenta primero sin PMF. Con
    PMF, al reiniciar la radio el router la rechazaba durante minutos
    («Association refused temporarily, comeback time 262144»). Si en 15 s
    no conecta (redes WPA3 puras), se reintenta con PMF.
    - Audio: si se pide una emisora sin WiFi (al reanudar justo tras
    encender), espera hasta 60 s a que conecte en vez de dar error.
    - CYD: tarjeta SD desactivada (-D SIN_SD); sus ~28 KB de RAM hacen falta
    para el audio. Con eso suena: MP3 128 kbps por el DAC y títulos ICY.
    [archivos_esp32.cpp, audio_esp32.cpp, red_esp32.cpp]
2026-10-31 Datos leídos sin cargarlos enteros en RAM (CYD con audio sonando)
    En la CYD, con el audio sonando, quedan ~45 KB libres y las regiones y
    listas salían vacías (regiones.json: NoMemory).
    - HAL: lectura secuencial con búfer de 512 bytes (hal_archivo_leer); en
    la placa, buscar en buscar.txt ya no va byte a byte.
    - JSON analizado directamente desde el archivo (ArduinoJson con un
    lector propio), sin copiarlo antes a RAM.
    - build_maps.py: regiones.json compacto, un archivo por región con sus
    países (regiones/<id>.json, 0,3–2,8 KB) y paises.txt (código y nombre,
    una línea por país); --solo-indices los regenera sin rehacer mapas.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
2026-10-31 Índice de emisoras en texto (indice.txt) para la placa
    Con el audio sonando, la CYD a veces no podía analizar emisoras/indice.json
    (209 países) y no sabía qué países apagar. Ahora el número de emisoras por
    país se lee de emisoras/indice.txt («ES<TAB>30» por línea), línea a
    línea; también lo usa la emisora aleatoria (dos pasadas: contar y elegir).
    build_stations.py genera indice.txt junto a indice.json.
2026-10-31 Instalador web con ESP Web Tools (GitHub Pages)
    - tools/build_release.py: compila cada placa, genera la imagen de datos y
    junta arranque, particiones, firmware y datos en un solo .bin con
    esptool merge-bin; escribe el manifest de ESP Web Tools (con espera
    para Improv, así la página ofrece configurar la WiFi al terminar).
    - docs/instalar/: página en español para elegir placa e instalar desde
    Chrome o Edge (ESP Web Tools 10.4.0), con los pasos de WiFi (Improv o
    portal con QR) y ayuda si no aparece la placa (driver CH340, BOOT).
    - Primera publicación: CYD Freenove FNK0114F, v0.1.
2026-10-31 v0.2: bilingüe (inglés y español), con el inglés siempre primero
    - Firmware: macro TR("English", "Español") en todas las pantallas; el
    primer arranque pregunta el idioma (English arriba, Español debajo) y se
    guarda en los ajustes. Mantener pulsado el título abre un menú de ajustes
    con el idioma y la red WiFi.
    - Datos: nombres de regiones y países en inglés (NAME_EN de Natural Earth
    más correcciones en config_regiones.json); en inglés las listas de
    países se ordenan sin tener en cuenta las tildes. Géneros traducidos.
    - Al cambiar de idioma se borra el mapamundi antes de crear el nuevo
    (comparten el mapa en memoria).
    - Web: /install/ en inglés (principal) e /instalar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
2026-11-01 Carcasa 3D: radio de sobremesa retro con altavoz de 40 mm
    OpenSCAD paramétrico para la FNK0104 y la CYD: cuerpo impreso boca
    abajo, tapa trasera con M3 y aro del altavoz. STL listos para imprimir,
    vistas en img/ y script para pasar a STEP. Encaje de la CYD comprobado
    contra el modelo de Freenove; las medidas de la FNK0104 están por
    verificar con la placa.
    [back_cover.stl, comprobar_choque.scad, front_cyd.stl, front_fnk0104.stl, radio.scad, speaker_ring.stl]
2026-11-01 Carcasa: ranuras de la tapa centradas y guías más robustas
    Las ranuras de ventilación estaban desplazadas (rect_redondo dibuja
    centrado) y atravesaban la pestaña. Ahora van centradas detrás de la
    placa, 7 ranuras lejos de la guía. La pestaña pasa a 2 mm de grosor y
    4 mm de alto, con chaflán de entrada. Nueva vista del interior de la tapa.
    [back_cover.stl, radio.scad]
2026-11-01 Carcasa: sin agujero bajo el texto y aro dentro de las paredes
    La torreta superior del aro del altavoz quedaba justo debajo de la «M»
    del texto grabado y el agujero guía dejaba solo 0,2 mm: se abría al
    imprimir. Ahora las torretas van a 30°, 150° y 270°, y todos los
    agujeros guía dejan 1,2 mm de frontal (piel_frente). El aro se recorta
    para no tocar la pared derecha. Tornillos ajustados en el README.
    [front_cyd.stl, front_fnk0104.stl, radio.scad, speaker_ring.stl]
2026-11-01 Carcasa: hueco USB 2 mm más alto hacia atrás
    Con la CYD real el cable chocaba con el borde trasero del hueco.
    [front_cyd.stl, front_fnk0104.stl, radio.scad]
2026-11-01 Carcasa CYD: pantalla real de 4,3 mm y tornillos M3 × 6
    En la placa real la pantalla es más gruesa que en el modelo de Freenove:
    la placa no llegaba a los postes y el USB-C quedaba detrás del hueco.
    [front_cyd.stl, radio.scad]
2026-11-01 CYD: base reducida con EE. UU., Cuba, España y Francia, solo http
    La CYD no tiene RAM para el cifrado https (SSL - Memory allocation failed).
    tools/build_cyd.py genera data_cyd/ con las emisoras http más populares de
    esos países y pinta como fondo las regiones sin emisoras; el entorno cyd la
    sube en vez de data/. Al arrancar no se reanuda una emisora https guardada.
    [ui_arranque.cpp]
2026-11-02 Carcasa: opción de altavoz de 52 mm con rejilla grande y placa del nombre
    altavoz = "52mm": asiento y aro para un altavoz de 52 × 32 mm, rejilla
    abierta de 40 mm con anillo decorativo grabado hasta 50 mm y una franja
    con el nombre que la cruza. Las ranuras de la rejilla quedan centradas.
    [front_cyd.stl, front_cyd_52.stl, front_fnk0104.stl, front_fnk0104_52.stl, radio.scad, speaker_ring_52.stl]
2026-11-02 Carcasa 52 mm: rejilla abierta de 46 mm para no tapar la suspensión del cono
    [front_cyd_52.stl, front_fnk0104_52.stl, radio.scad]
2026-11-02 Apagar desde la pantalla: «Desliza para apagar» y despertar al tocar
    En el menú de ajustes, un deslizador que solo se agarra por el botón apaga
    la radio: guarda los ajustes, apaga audio, amplificador y pantalla, y el
    ESP32 entra en sueño profundo. Despierta con el aviso de toque del XPT2046
    (GPIO36 en la CYD, según el esquema de Freenove) y vuelve a sonar la última
    emisora. Los pines de la pantalla, el amplificador y el táctil se quedan
    fijos mientras duerme. Probado en la CYD. El simulador cierra la ventana
    y su guion de pruebas admite «arrastra».
2026-11-02 Luz: el LED de la placa al ritmo de la música
    Modo «ritmo» (por defecto): el LED recorre el arcoíris despacio y su brillo
    late con la música, medida en cada muestra que sale al DAC. Modo «fija»:
    el color (saturado) de la región de la emisora en el mapamundi. Además,
    ámbar al conectar, tres destellos rojos si la emisora falla y azul con el
    portal WiFi. Se elige en Ajustes (Luz: ritmo / no / fija) y se guarda.
    Reutiliza del contador de YouTube los pines, el PWM de 12 bits y el
    balance de blancos 192/255/82; canales LEDC 0-2, aparte de la pantalla.
    El LED se queda apagado mientras la radio duerme. Probado en la CYD.
2026-11-03 FNK0104, Fase 1: pantalla, táctil capacitivo y base completa
    Nuevo entorno fnk0104 (ESP32-S3, 8 MB de PSRAM octal y 16 MB de flash,
    comprobados en la placa) con particiones de 16 MB y la base completa de
    data/. Pantalla ILI9341 con LovyanGFX girada para el USB a la izquierda
    (Freenove la usa al revés) y táctil FT6336 por I2C. El táctil de cada
    placa pasa a tactil_xpt2046.cpp / tactil_ft6336.cpp. El audio de esta
    placa (ES8311) llega en la Fase 2: de momento hace como que suena.
    Probado en la placa: imagen, colores y táctil correctos.
    [particiones_16mb.csv]
2026-11-03 FNK0104: imagen y táctil derechos en la carcasa, botones de borde más fáciles
    Con la placa montada en la carcasa la pantalla va en el giro 1 (el de los
    ejemplos de Freenove). El táctil se midió en la placa tocando las cuatro
    esquinas: con LovyanGFX va media vuelta respecto al ejemplo con TFT_eSPI.
    «Cancelar» del portal WiFi, más grande, y los botones de la cabecera
    aceptan toques un poco fuera de su borde. Probado en la placa.
2026-11-03 FNK0104, Fase 2: audio por el códec ES8311
    Salida I2S (MCLK 4, BCK 5, WS 7, datos 8) hacia el ES8311, configurado por
    I2C en el mismo bus que el táctil, con el controlador oficial de Espressif
    (Apache-2.0) que trae el ejemplo de Freenove. Los divisores del códec
    siguen la frecuencia de cada emisora (22,05/44,1/48 kHz...) y el volumen
    lo pone el códec (de -44,5 dB a 0 dB), con la librería al máximo: suena
    limpio también a volumen bajo. Con la PSRAM suenan las emisoras https.
    Probado en la placa.
2026-11-03 FNK0104, Fase 3a: LED WS2812, apagado y control de intensidad de la luz
    El LED direccionable de la FNK0104 (GPIO42, ejemplo Sketch_02.1_LedPixel de
    Freenove) hace lo mismo que el de la CYD: arcoíris al ritmo de la música,
    color de la región y avisos. Antes de dormir se le manda negro, que si no
    se queda con el último color. Nuevo ajuste «Brillo: bajo / medio / alto»
    (alto = el LED a tope) en las dos placas. Apagar con el deslizador y
    despertar tocando la pantalla, probado en la placa.
2026-11-03 Carcasa: un solo frontal para la FNK0104 y la CYD
    La FNK0104 montada en el frontal impreso para la CYD queda con la pantalla
    centrada, apoya en los postes y el USB-C entra: usa las mismas medidas. Los
    frontales por placa pasan a ser front.stl (altavoz de 40 mm) y
    front_52.stl (52 mm).
    [front.stl, front_52.stl, front_cyd.stl, front_cyd_52.stl, front_fnk0104.stl, front_fnk0104_52.stl, radio.scad]
2026-11-03 FNK0104: táctil estirado hacia los bordes
    El FT6336 lee los toques encogidos hacia el centro: la flecha de atrás
    (y = 15) se leía entre 21 y 48 y a veces abría la primera emisora de la
    lista. Se estiran las lecturas con lo medido en la placa (x 31..296 ->
    10..310, y 33..217 -> 12..228). Medido también que el bucle va igual de
    fluido con y sin audio: no era eso. Probado en la placa.
2026-11-03 Arreglo: reinicio al cambiar de pantalla dos veces a la vez
    El volcado de la FNK0104 (coredump en flash) señalaba lv_obj_get_screen
    desde nav_atras(): el aviso de emisora caída vuelve atrás solo y, si a la
    vez se tocaba «Atrás», LVGL usaba una pantalla que ya se estaba borrando.
    Mientras dura la animación de un cambio de pantalla se ignora otro cambio;
    nav_reiniciar() (cambio de idioma) carga el mapamundi sin esa espera.
    [nav.cpp]
2026-11-03 Instalador web: la FNK0104 ya se puede instalar desde el navegador
    Nueva tabla de 16 MB con los datos (6 MB) justo detrás del programa: el
    archivo del instalador pesa 9 MB en vez de 16. app1 queda reservada para
    actualizar por WiFi más adelante. build_release.py genera la FNK0104
    (ESP32-S3, arranque en 0x0) y las páginas /install/ e /instalar/ la
    ofrecen como placa recomendada; la CYD queda como limitada (sin https).
    [particiones_16mb.csv]
2026-11-03 Se abandona la CYD: el proyecto sigue solo con la FNK0104
    La CYD (sin PSRAM) no puede con las emisoras https y su DAC de 8 bits
    suena mal bajito. Fuera del instalador web, del firmware (entorno cyd,
    táctil XPT2046, audio por el DAC interno, LED de tres pines, tabla de 4 MB)
    y de las herramientas (base reducida data_cyd/, build_cyd.py, pio_cyd.py,
    --paises y --solo-http). La carcasa y los README hablan solo de la
    FNK0104; el frontal no cambia. Todo sigue en el historial de git.
    [comprobar_choque.scad, particiones_4mb.csv, radio.scad]
2026-11-03 Reposo nuevo: reloj grande, el tiempo y la calidad del aire
    La pantalla de reposo pasa cada 10 s, con fundido, por tres páginas: reloj
    de 72 px con la fecha y lo que suena; el tiempo de ahora y de los 3 días
    siguientes; la calidad del aire (índice europeo con sus colores, PM2.5) y
    la salida y puesta del sol. Todo se desliza despacio para no marcar la
    pantalla. Ubicación por la IP (ip-api.com) y datos de Open-Meteo, sin
    claves, cada 30 minutos en segundo plano. La hora se ajusta a la zona de
    la ubicación. Nuevas funciones de la HAL: hal_fecha, hal_zona_horaria,
    hal_http_get y hal_segundo_plano. Instalador web actualizado.
2026-11-03 Reposo: sin deslizamiento visible
    En vez de deslizar todo despacio (redibujar la pantalla entera durante 4 s
    se veía a saltos), cada página aparece unos píxeles desplazada: se mueve
    mientras aún es transparente, antes del fundido. Instalador actualizado.
2026-11-05 Arreglo: reinicio al cambiar de emisora
    Volcado de la FNK0104: assert en lfs_file_read porque la tarea de audio
    cerraba el archivo que leía la pantalla. Fallo del núcleo de Arduino:
    stop_ssl_socket() deja el socket en 0 con un memset y el siguiente
    WiFiClientSecure::stop() hace close(0), que es el primer archivo abierto de
    LittleFS. La librería de audio llama a stop() en cada cambio de emisora.
    Con -Wl,--wrap=close se ignora close(0); fclose() no pasa por ahí.
    Instalador actualizado. Probado en la placa.
    [sistema_esp32.cpp]
2026-11-05 Alarmas, fase 1: programarlas y que suenen
    Hasta 5 alarmas con hora, días de la semana y activa o no (sin días, suena
    una vez). Se programan en Ajustes > Alarmas y se guardan con los ajustes.
    Al sonar, aviso a pantalla completa y la última emisora. En Ajustes, el
    idioma pasa a un botón para dejar sitio a las alarmas.
2026-11-05 Alarmas, fase 2: emisora, volumen progresivo y tono de emergencia
    Cada alarma tiene su volumen y puede sonar con la última emisora o con una
    favorita. El volumen sube del 30 % al final en un minuto. Si no hay WiFi,
    no hay emisora o falla en 15 s, suena un tono original guardado en la
    placa (tools/build_tono.py). Sin apagarla, se para a los 30 minutos.
2026-11-05 Alarmas: volumen de inicio audible
    Empezar al 30 % del volumen final apenas se oía, porque el volumen va en
    decibelios. Ahora empieza 30 puntos por debajo y llega en 30 s (15 s el
    tono). Alarmas nuevas al 85 %. Aviso si aún no hay favoritas.
2026-11-05 Reproduciendo: del país a su lista y vuelta por la región
    El nombre del país se puede tocar: abre la lista de emisoras de ese país
    con el camino de vuelta por la región y el mapamundi, se llegara como se
    llegara. La búsqueda de la región pasa a datos.cpp (la usa también la luz).
2026-11-05 Alarmas, fase 3: sonar con la radio apagada
    Antes de dormir se programa un temporizador para la próxima alarma, con
    margen (2 minutos o un 2 % de lo dormido, porque el reloj se desvía). Al
    despertar sola, arranca a oscuras y sin música; si aún falta, corrige la
    hora por Internet y vuelve a dormir. Un toque enciende la radio normal.
    [alarmas.cpp, alarmas.h, hal.h, pantalla_esp32.cpp, pantalla_pc.cpp, ui_ajustes.cpp, ui_arranque.cpp, ui_reposo.cpp]
2026-11-05 Alarmas: no volver a dormir justo a la hora de la alarma
    Al despertar a oscuras, en el minuto de la alarma esta ya no contaba como
    próxima y la radio se dormía sin sonar: primero se comprueba el reloj. El
    registro indica el motivo de arranque y a qué tiempo se programa despertar.
2026-11-05 Alarmas: deslizador más fácil y pruebas del sonido tras despertar
    Deslizador: vale empezar en su mitad izquierda y llegar al 80 %. El códec
    se configura con el reloj en marcha y la librería de audio se crea al
    arrancar. Sin resolver: en el arranque de una alarma el audio llega a la
    salida pero no se oye. Quedan avisos [prueba] temporales en el registro.
    [audio_esp32.cpp, ui_ajustes.cpp]
2026-11-05 Audio: la librería vuelve a crearse al pedir la primera emisora
    Creada al arrancar, no se oía nada ni en un arranque normal.
2026-11-06 Alarmas: el audio se prepara al terminar el logo
    Al despertar para una alarma, la librería de audio se creaba a la hora de
    sonar y toda esa sesión salía muda. Ahora audio_preparar() la crea al
    terminar el logo, en silencio, igual que en un arranque normal.
    Quita también los avisos temporales de prueba.
2026-11-06 Alarmas, fase 4: posponer, amanecer y temporizador para dormir
    - Posponer repite la alarma a los 10 minutos.
    - Amanecer: opción por alarma; el LED sube 10 minutos antes, y la radio
    despierta antes para hacerlo.
    - Temporizador «Zz» en la pantalla de reproducción: baja el volumen en
    el último minuto y apaga la radio.
    - La lista de sonido enseña la emisora de la alarma aunque ya no sea
    favorita.
2026-11-07 Recientes: lista de las 10 últimas emisoras
    Se abre con un botón en la cabecera de Favoritos y se guarda con los
    ajustes.
2026-11-07 Títulos: leer Latin-1 y otros alfabetos sin signos de interrogación
    Las codificaciones antiguas se decodifican, el cirílico y el griego se
    transliteran, y lo que la fuente no tiene se quita; si no queda casi
    nada legible, no se muestra título.
2026-11-07 Hora local de la emisora mientras suena
    Tabla de zonas por país generada con tools/build_zonas.py, con el
    horario de verano y excepciones temporales como la de Cuba. Los países
    con varias zonas usan la de su capital o ciudad principal.
2026-11-07 Emisoras que fallan y User-Agent para zeno.fm
    Las emisoras que no llegan a sonar dos veces seguidas con la WiFi bien
    bajan al final de la lista, en gris, y el modo aleatorio las evita. Al
    volver a sonar se recuperan.
    La librería de audio no manda User-Agent y zeno.fm (395 de 3647
    emisoras) rechazaba las peticiones con un 401. tools/pio_audio.py añade
    el encabezado al compilar.
2026-11-07 Emisoras: base nueva, probada como las pide la placa
    build_stations.py comprueba además que el servidor responde con audio
    a una petición con los mismos encabezados que la placa.
2026-11-07 Actualizar emisoras por Internet, sin flashear
    La radio descarga un paquete, comprueba su tamaño y su suma y lo
    desempaqueta aparte; la marca final hace que un corte de luz no deje una
    mezcla de archivos. La URL de prueba apunta a esta rama.
2026-11-07 Paquete de emisoras como binario
    Git cambiaba sus saltos de línea y la suma de control dejaba de coincidir.
2026-11-07 Actualizar emisoras: la versión instalada sale de la marca final
    Tras un corte de luz a medias decía «al día» aunque la radio usara la
    lista de fábrica.
2026-11-07 Versión 0.4: alarmas, recientes, hora local y actualizar emisoras
    Dirección definitiva de las emisoras en GitHub Pages, README al día e
    instalador regenerado.
2026-11-07 Manual en inglés y español, y dos correcciones de pantalla (v0.4.1)
    - docs/manual: instalación y uso, con capturas del simulador generadas
    por tools/build_capturas.py.
    - Actualizar: el título se cortaba.
    - WiFi: el botón Cancelar tapaba la dirección 192.168.4.1.
2026-11-07 Manual: fotos reales de la radio
    Portada, placa, tamaño, tocar el mapa, reproducción, primer arranque y
    LED, sacadas de las fotos y vídeos del montaje.
2026-11-07 Manual: apartado de montaje de la carcasa
    Alargar el cable del altavoz (soldando, o comprarlo con cable largo),
    atornillar la placa y fijar el altavoz con silicona (recomendado).
2026-11-07 Manual: tornillos y ajustes de impresión de la carcasa pequeña
    Medidos en el diseño (versión 2): placa 4 × M3 × 5 (postes de 4 mm),
    tapa 4 × M3 × 8. Ajustes sacados de los archivos del laminador.
2026-11-07 Carcasa pequeña: archivos de la versión 2 y enlaces
    3MF, STL (orientados para imprimir) y STEP del frontal y la tapa, con
    README en inglés y español. El manual y la carcasa retro enlazan a ella.
    [back_cover.3mf, back_cover.step, back_cover.stl, front.3mf, front.step, front.stl]
2026-11-07 Manual: la foto de la placa y la de la mano sin escalado pixelado
2026-11-07 Manual: quitar la foto del primer arranque, con la pantalla al revés
2026-11-07 Montaje: aviso de orientación de la placa
    Con la radio sobre sus patas, la pantalla al derecho; el USB-C en el
    extremo contrario al altavoz.
2026-11-07 Manual: orden de las fotos del montaje
2026-11-07 Manual y README: dónde comprar la placa (versión táctil) con enlaces de afiliado
2026-11-08 Manual y README: enlace a la carcasa en MakerWorld
2026-11-08 Manual y README: enlace a la carcasa en Printables
2026-11-08 Manual y README: enlace a la guía de Instructables y al vídeo
2026-11-08 Boombox: piezas de referencia para la carcasa y carpetas por proyecto
    - carcasa/boombox: referencia.py (Python + OCP) genera en STEP y STL la
    cavidad en huevo (~3,08 L netos, trasera en punta a 45°), un altavoz
    de 4" maniquí y el bloque del amplificador TPA3116D2. README EN/ES.
    - .gitignore: ignora las carpetas locales RADIO MUNDIAL SMALL y
    RADIO MUNDIAL BOOMBOX (fotos, vídeos, SolidWorks, copias de la flash)
    en lugar de VIDEOS Y FOTOS.
    [altavoz_maniqui.step, altavoz_maniqui.stl, amplificador_bloque.step, amplificador_bloque.stl, huevo_cavidad.step, huevo_cavidad.stl]
2026-11-08 Carcasa: retirar la versión OpenSCAD (40 y 52 mm), que no se usó
    La carcasa publicada es la pequeña de SolidWorks (carcasa/pequena).
    carcasa/README.md pasa a ser un índice de pequena/ y boombox/.
    [back_cover.stl, front.stl, front_52.stl, radio.scad, speaker_ring.stl, speaker_ring_52.stl]
2026-11-12 Boombox: prueba de altavoz Bluetooth (Fase A) y conexionado en PDF
    Firmware mínimo para el ESP32 DevKit (WROOM-32): recibe audio por
    Bluetooth A2DP como "Radio Mundial BT" y lo saca por I2S al DAC
    PCM5102A (WCMCU-5102) hacia el amplificador TPA3116D2. Sirve para
    probar las cápsulas antes de pasar a la Freenove FNK0104.
    - boombox/prueba_bt/platformio.ini: espressif32@6.12.0, librerías
    ESP32-A2DP v1.8.12 y arduino-audio-tools v1.3.0 fijadas.
    - src/main.cpp: I2S en GPIO 26 (BCK), 25 (LCK) y 22 (DIN).
    - conexionado.py genera CONEXIONADO_PRUEBA_BT.pdf (esquema y pasos).
    Compila; falta probarlo en la placa real.
2026-11-13 Boombox: salida de audio por DAC externo I2S (Fase 7, sin probar)
    En la FNK0104 el sonido puede salir por el altavoz integrado (ES8311,
    como hasta ahora) o por un DAC externo (PCM5102A o UDA1334A) hacia un
    amplificador. Se elige con un botón nuevo en la esquina de Ajustes y se
    guarda en los ajustes. Por defecto, altavoz integrado: sin cambios para
    la radio pequeña.
    - placa.h: pines del DAC externo en el conector P3 (IO14 BCK, IO21 WS,
    IO2 DIN), sin MCLK. Alimentación desde P2 (+5 V y GND).
    - audio_esp32.cpp: con el DAC externo, el amplificador integrado queda
    apagado y el volumen se aplica a las muestras (-40 a +6 dB). Al cambiar
    de salida se rehace la librería y vuelve a sonar lo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
